michifx512/FM-ArtNetNode_4U_V2/photos/3D.jpg

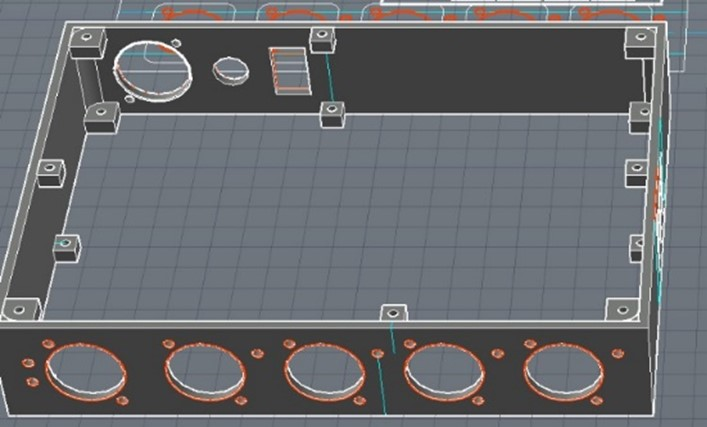
photos/3D.jpg
