michifx512/FM-ArtNetNode_4U_V2/photos/CLOSED BACK.jpg

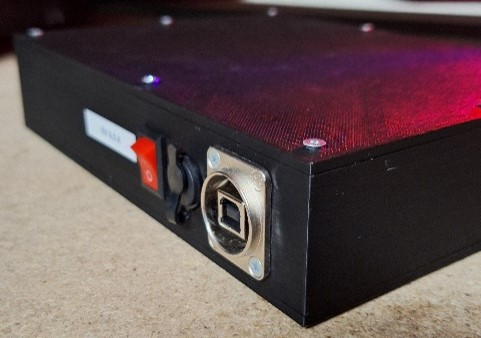
photos/CLOSED BACK.jpg
