michifx512/FM-ArtNetNode_4U_V2/(commit log)

2023-12-18 Added LED code, not complete
    added ethernet led code, minor changes
    Added LED code (to be tested)
    New LED code, to be tested
    Update ArtNetNode_4U_V2.ino
    update sketch
2024-01-03 Fixed minor bugs, changed IP to Preferred ArtNet
    [ArtNetNode_4U_V2.ino]
2024-05-31 Fixed Subnet+Universe Combination, minor cleanup
    [ArtNetNode_4U_V2.ino]
2024-11-13 Fixed ArtPollReply, Added Beta Version files (TO BE TESTED)
    [FastLED_timers.h, Test_ArtNetNode_4U_V2.ino]
2024-11-14 MAJOR UPDATE v2.2.0: Improved output timing accuracy, fixed ArtPollReply
    [ArtNetNode_4U_V2.ino]
