michifx512/FM-ArtNetNode_4U_V2/photos/FRONT ANGLE.jpg

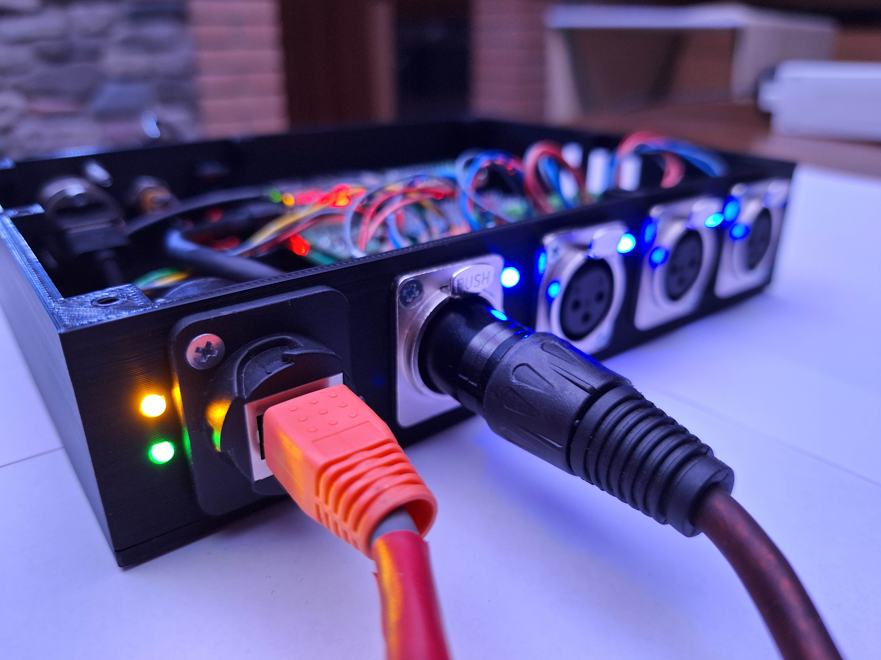
photos/FRONT ANGLE.jpg
