michifx512/FM-ArtNetNode_4U_V2/photos/SIDE.jpg

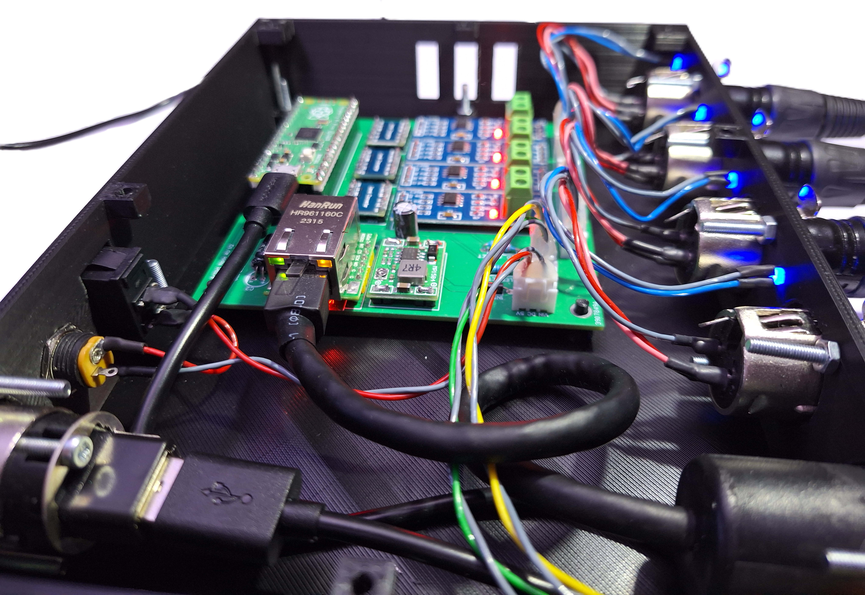
photos/SIDE.jpg
