michifx512/FM-ArtNetNode_4U_V2/photos/TOP.jpg

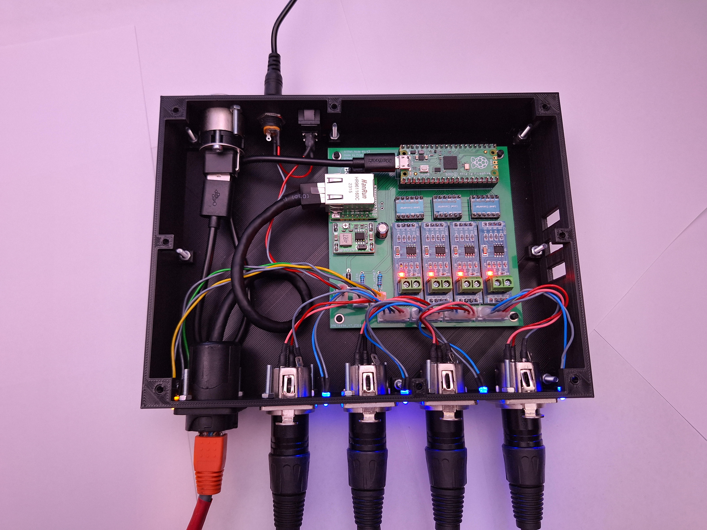
photos/TOP.jpg
