michifx512/FM-ArtNetNode_4U_V2/photos/EXTERNAL.jpg

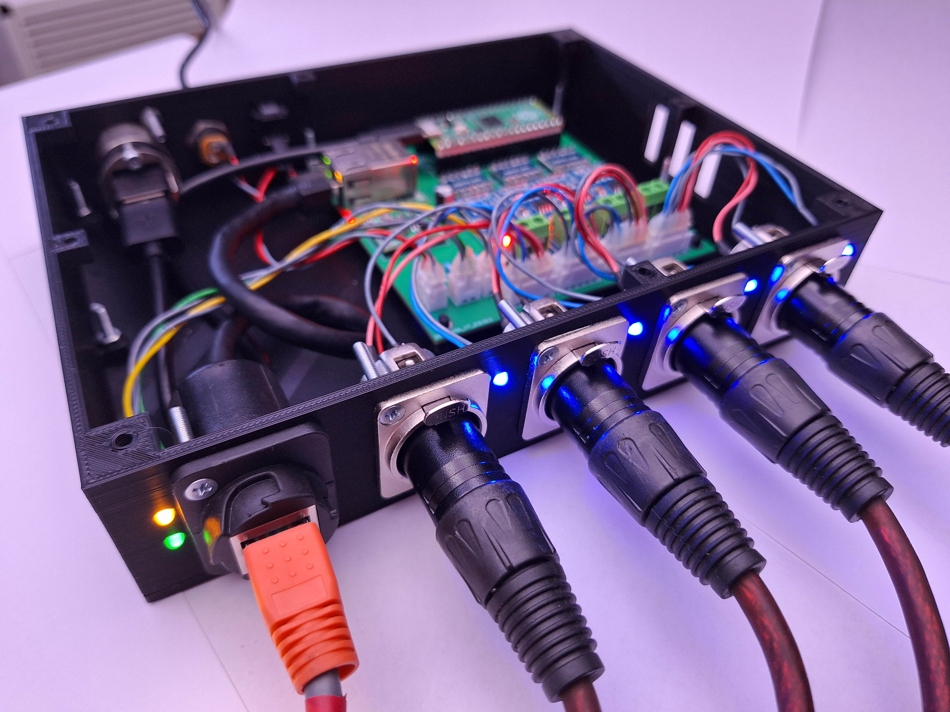
[picture p2: photos/EXTERNAL.jpg]
photos/EXTERNAL.jpg
