michifx512/FM-ArtNetNode_4U_V2/photos/INTERNAL.jpg

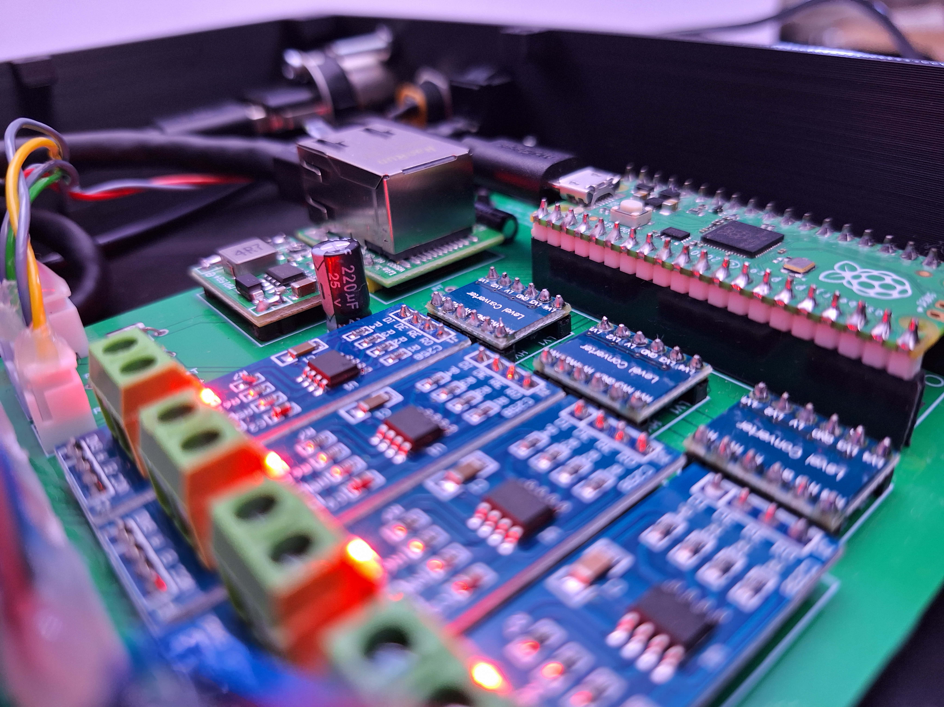
[picture p3: photos/INTERNAL.jpg]
photos/INTERNAL.jpg
