michifx512/FM-ArtNetNode_4U_V2/photos/LIGHTS.jpg

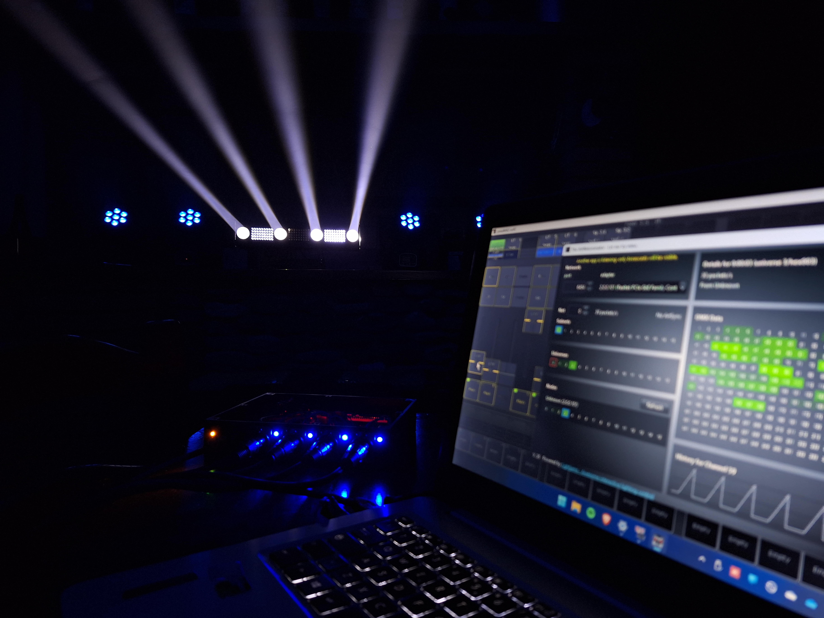
[picture p5: photos/LIGHTS.jpg]
photos/LIGHTS.jpg
